MightyPork/lorabees/(commit log)

2017-11-02 added all stuff
    [proj Debug.cfg]
2017-11-02 added driver directories and bsp
2017-11-02 add some fils
    [Bees3 Debug.cfg]
2017-11-18 got the voc sensor to do something
2018-03-18 added documentation, video and sample data
    [msg.csv, sample.ods]
